jagt48/split_keeb/docs/micro_selection.md

# Microcontroller Selection
Comparison of various STM32 microcontrollers

## Options
| Option | Micro | Dev Board | Max Flash | Max RAM | USB 2.0 | USB OTG |  
| ---- | ---- | ---- | ---- | ---- | ---- | ---- |
| 1 | STM32F303K8 | NUCLEO-F303K8 | 64 KB | 16 KB | No | No |
| 2 | STM32F042K6 | NUCLEO-F042K6 | 32 KB | 6 KB | Yes | No |
| 3 | STM32G031K8 | NUCLEO-G031K8 | 64 KB | 8 KB | No | No |
| 4 | STM32L432KC | NUCLEO-L432KC | 256 KB | 64 KB | Yes | No |
| 5 | STM32G431KB | NUCLEO-L432KC | 256 KB | 32 KB | Yes | No |
| 6 | STM32G431KB | NUCLEO-L432KC | 256 KB | 32 KB | Yes | No |
| 7 | RP2040 | Raspberry Pi Pico | 16 MB | 32 KB | Yes | No |
| 6 | STM32L072CB | NUCLEO-L072CB | 256 KB | 32 KB | Yes | No |
