jagt48/split_keeb/pcb/gat_blaster_36.kicad_pcb

## KiCad design pcb/gat_blaster_36.kicad_pcb (2024-03-23)

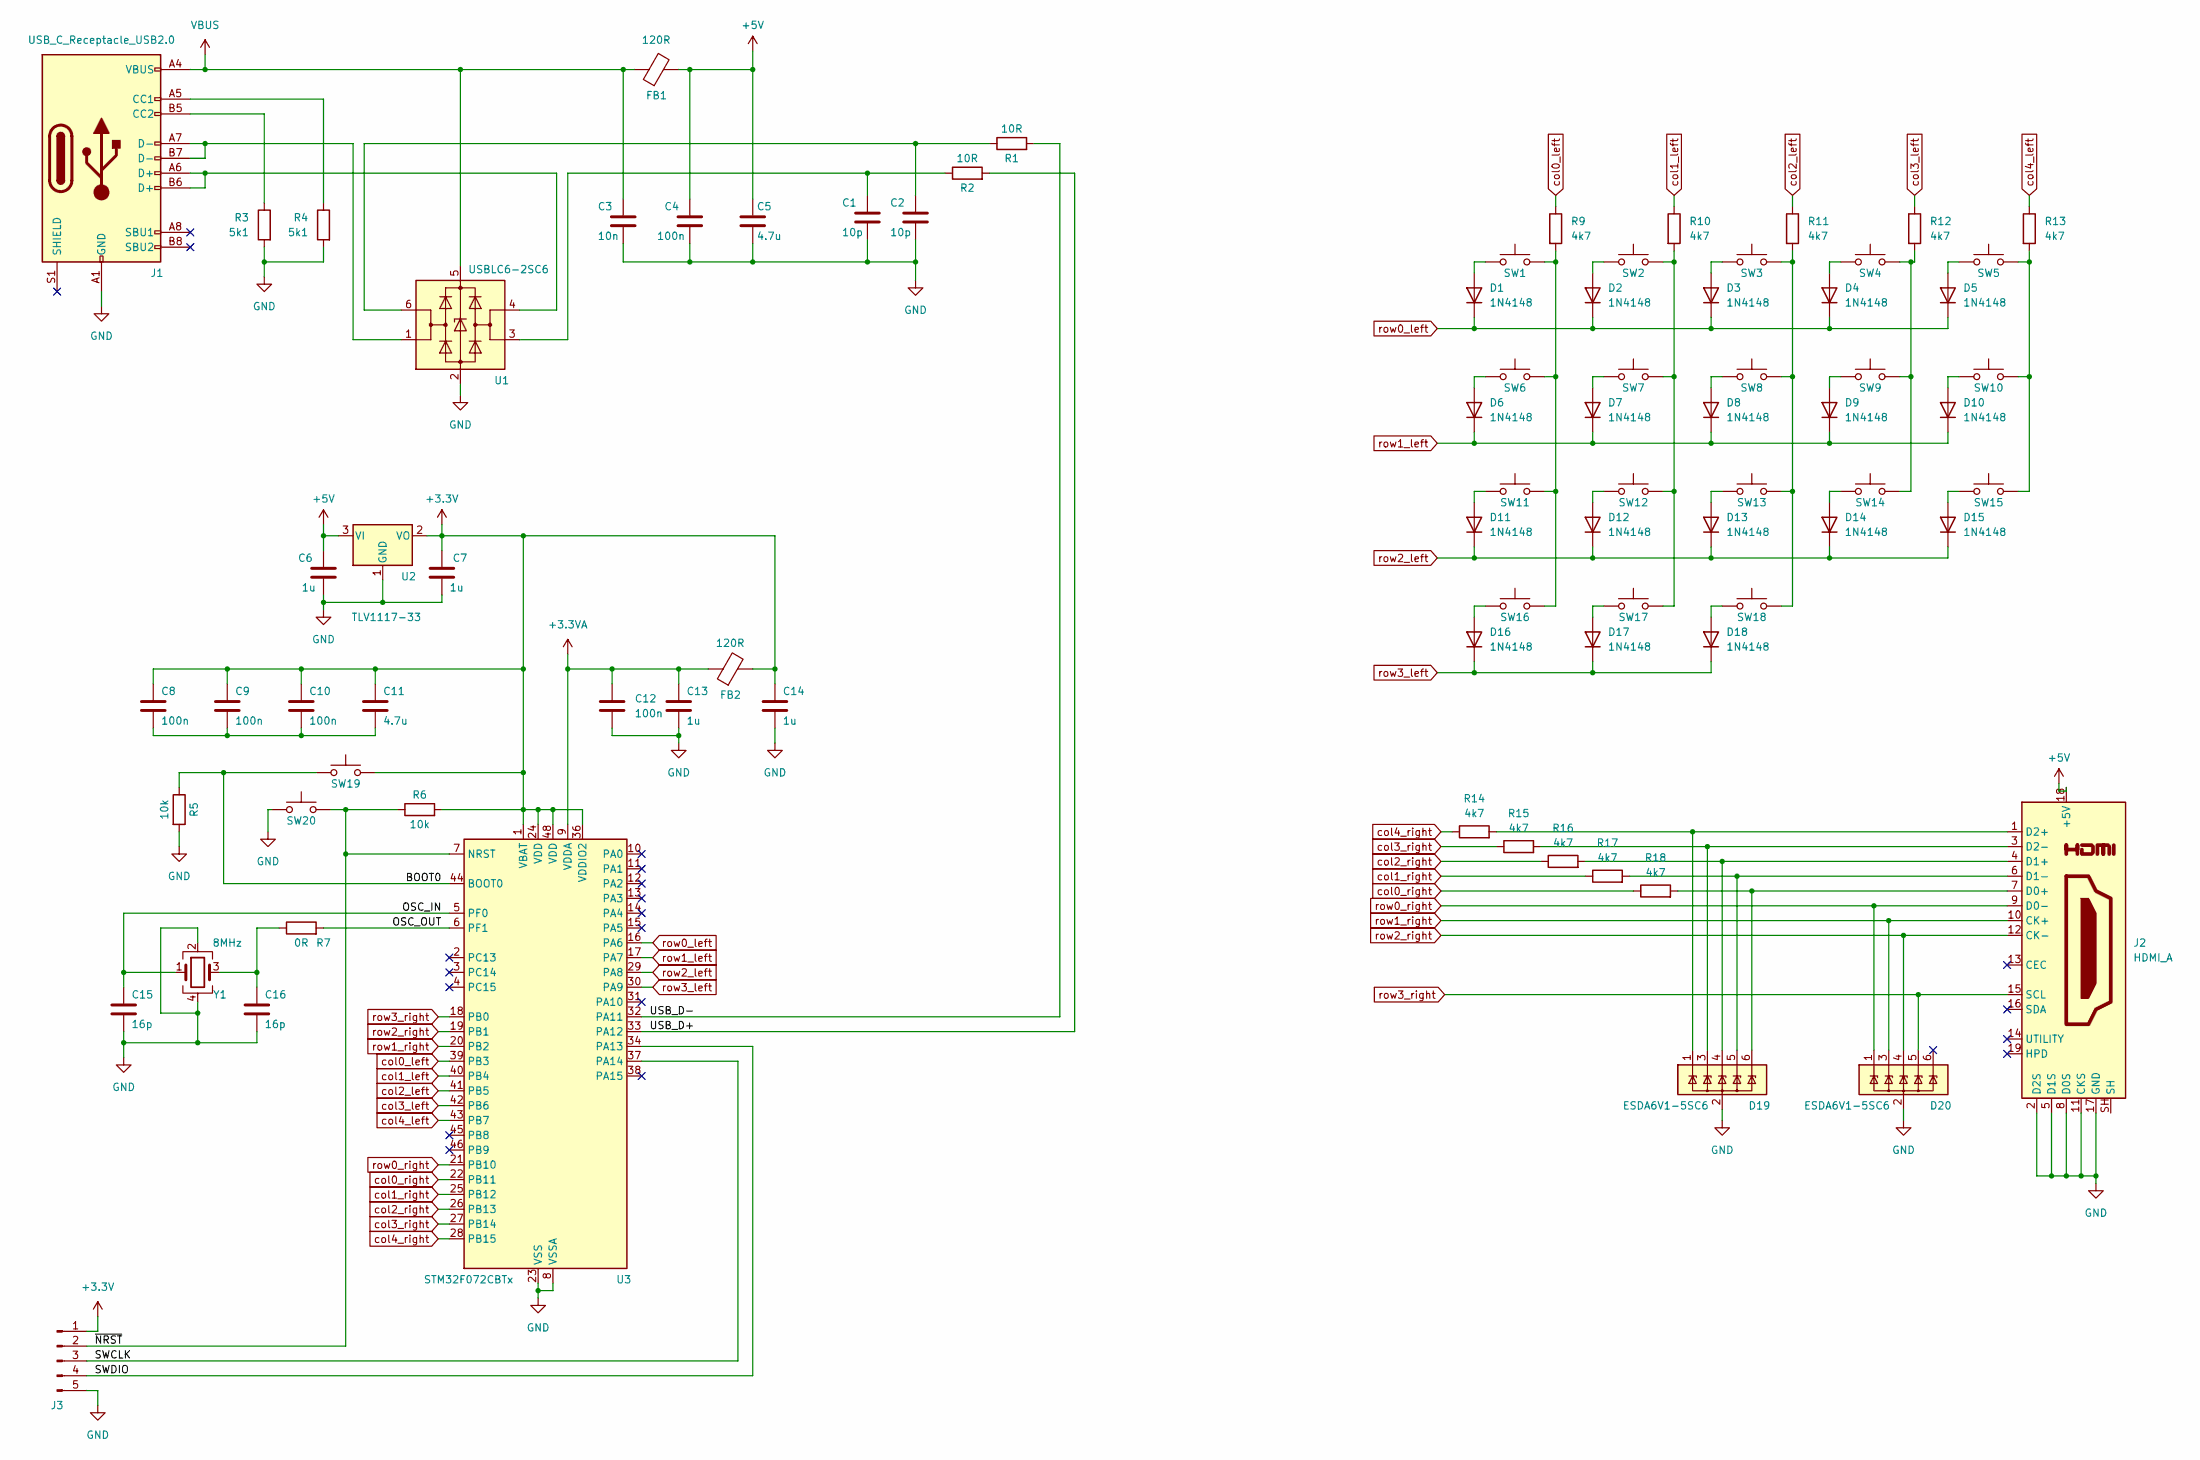
[picture p8: schematic gat_blaster_36.kicad_sch]

Parts:
C1, C2: 10p; 0603
C3: 10n; 0603
C4, C8, C9, C10, C12: 100n; 0603
C5, C11: 4.7u; 0603
C6, C7, C13, C14: 1u; 0603
C15, C16: 16p; 0603
D1, D2, D3, D4, D5, D6, D7, D8, D9, D10, D11, D12, D13, D14, D15, D16, D17, D18: 1N4148; sod123_mmszxxxt1g
D19, D20: ESDA6V1-5SC6; sot23-6L_usblc6-2
FB1, FB2: 120R; 0603
J1: USB_C_Receptacle_USB2.0; usb-c_usb4085
J2: HDMI_A; hdmi_cnc_tech_2000-1-1-20-00-bk
J3: Conn_01x05_Pin; SIP-5
R1, R2: 10R; 0603
R3, R4: 5k1; 0603
R5, R6: 10k; 0603
R7: 0R; 0603
R9, R10, R11, R12, R13, R14, R15, R16, R17, R18: 4k7; 0603
SW1, SW2, SW3, SW4, SW5, SW6, SW7, SW8, SW9, SW10, SW11, SW12, SW13, SW14, SW15, SW16, SW17, SW18: SW_Push; gateron_pro_5_reversible
SW19, SW20: SW_Push; sw_pts647
U1: USBLC6-2SC6; sot23-6L_usblc6-2
U2: TLV1117-33; sot223_tl1117
U3: STM32F072CBTx; QFP-48_7x7_Pitch0.5mm
Y1: 8MHz; osc_ecx-32

Connections:
+3.3V: C7.1, C8.1, C9.1, C10.1, C11.1, C14.1, FB2.2, J3.1, R6.2, SW19.2, U2.2 (VO), U3.1 (VBAT), U3.24 (VDD), U3.36 (VDDIO2), U3.48 (VDD)
+3.3VA: C12.1, C13.1, FB2.1, U3.9 (VDDA)
+5V: C4.1, C5.1, C6.1, FB1.2, J2.18 (+5V), U2.3 (VI)
/BOOT0: R5.1, SW19.1, U3.44 (BOOT0)
/OSC_IN: C15.1, U3.5 (PF0), Y1.1
/OSC_OUT: R7.2, U3.6 (PF1)
/SWCLK: J3.3, U3.37 (PA14)
/SWDIO: J3.4, U3.34 (PA13)
/USB_D+: R2.2, U3.33 (PA12)
/USB_D-: R1.2, U3.32 (PA11)
/~NRST: J3.2, R6.1, SW20.2, U3.7 (NRST)
GND: C1.2, C2.2, C3.2, C4.2, C5.2, C6.2, C7.2, C12.2, C13.2, C14.2, C15.2, C16.2, D19.2 (GND), D20.2 (GND), J1.A1 (GND), J1.A12 (GND), J1.B1 (GND), J1.B12 (GND), J2.2 (D2S), J2.5 (D1S), J2.8 (D0S), J2.11 (CKS), J2.17 (GND), J3.5, R3.2, R4.2, R5.2, SW20.1, U1.2 (GND), U2.1 (GND), U3.8 (VSSA), U3.23 (VSS), U3.35 (VSS), U3.47 (VSS), Y1.2, Y1.4
unnamed: C1.1, R2.1, U1.3 (I/O2)
unnamed: C2.1, R1.1, U1.6 (I/O1)
unnamed: C8.2, C9.2, C10.2, C11.2
unnamed: C16.1, R7.1, Y1.3
unnamed: D1.2 (A), SW1.1
unnamed: D2.2 (A), SW2.1
unnamed: D3.2 (A), SW3.1
unnamed: D4.2 (A), SW4.1
unnamed: D5.2 (A), SW5.1
unnamed: D6.2 (A), SW6.1
unnamed: D7.2 (A), SW7.1
unnamed: D8.2 (A), SW8.1
unnamed: D9.2 (A), SW9.1
unnamed: D10.2 (A), SW10.1
unnamed: D11.2 (A), SW11.1
unnamed: D12.2 (A), SW12.1
unnamed: D13.2 (A), SW13.1
unnamed: D14.2 (A), SW14.1
unnamed: D15.2 (A), SW15.1
unnamed: D16.2 (A), SW16.1
unnamed: D17.2 (A), SW17.1
unnamed: D18.2 (A), SW18.1
unnamed: D19.1 (IO1), J2.1 (D2+), R14.2
unnamed: D19.3 (IO2), J2.3 (D2-), R15.2
unnamed: D19.4 (IO3), J2.4 (D1+), R16.2
unnamed: D19.5 (IO4), J2.6 (D1-), R17.2
unnamed: D19.6 (IO5), J2.7 (D0+), R18.2
unnamed: J1.A5 (CC1), R4.1
unnamed: J1.B5 (CC2), R3.1
unnamed: J1.A6 (D+), J1.B6 (D+), U1.4 (I/O2)
unnamed: J1.A7 (D-), J1.B7 (D-), U1.1 (I/O1)
unnamed: R9.2, SW1.2, SW6.2, SW11.2, SW16.2
unnamed: R10.2, SW2.2, SW7.2, SW12.2, SW17.2
unnamed: R11.2, SW3.2, SW8.2, SW13.2, SW18.2
unnamed: R12.2, SW4.2, SW9.2, SW14.2
unnamed: R13.2, SW5.2, SW10.2, SW15.2
VBUS: C3.1, FB1.1, J1.A4 (VBUS), J1.A9 (VBUS), J1.B4 (VBUS), J1.B9 (VBUS), U1.5 (VBUS)
col0_left: R9.1, U3.39 (PB3)
col0_right: R18.1, U3.22 (PB11)
col1_left: R10.1, U3.40 (PB4)
col1_right: R17.1, U3.25 (PB12)
col2_left: R11.1, U3.41 (PB5)
col2_right: R16.1, U3.26 (PB13)
col3_left: R12.1, U3.42 (PB6)
col3_right: R15.1, U3.27 (PB14)
col4_left: R13.1, U3.43 (PB7)
col4_right: R14.1, U3.28 (PB15)
row0_left: D1.1 (K), D2.1 (K), D3.1 (K), D4.1 (K), D5.1 (K), U3.16 (PA6)
row0_right: D20.1 (IO1), J2.9 (D0-), U3.21 (PB10)
row1_left: D6.1 (K), D7.1 (K), D8.1 (K), D9.1 (K), D10.1 (K), U3.17 (PA7)
row1_right: D20.3 (IO2), J2.10 (CK+), U3.20 (PB2)
row2_left: D11.1 (K), D12.1 (K), D13.1 (K), D14.1 (K), D15.1 (K), U3.29 (PA8)
row2_right: D20.4 (IO3), J2.12 (CK-), U3.19 (PB1)
row3_left: D16.1 (K), D17.1 (K), D18.1 (K), U3.30 (PA9)
row3_right: D20.5 (IO4), J2.15 (SCL), U3.18 (PB0)

Board: 2 copper layers, 82 parts (33 on the bottom side), 67 nets, no tracks yet.
