jagt48/split_keeb/(commit log)

2023-11-05 Added micro, LDO, decoupling caps, oscillator, debeg header, boot/reset switches, and USB-C connector
    [gat_blaster_36.kicad_pcb, gat_blaster_36.kicad_sch]
2023-11-05 Added USB 5V filter
    [gat_blaster_36.kicad_sch]
2023-11-18 Added series resistors on data lines, changed left/right communication cable to HDMI connector, fully supported by single micro.
    [gat_blaster_36.kicad_pcb, gat_blaster_36.kicad_sch]
2024-03-23 latest work from len pc
    [gat_blaster_36.kicad_pcb]
